a2zhelna/Power-Meter/KiCad Files/PowerMeter_PS_current/project_library/282834-2/STEP/c-282834-2-c-3d.stp

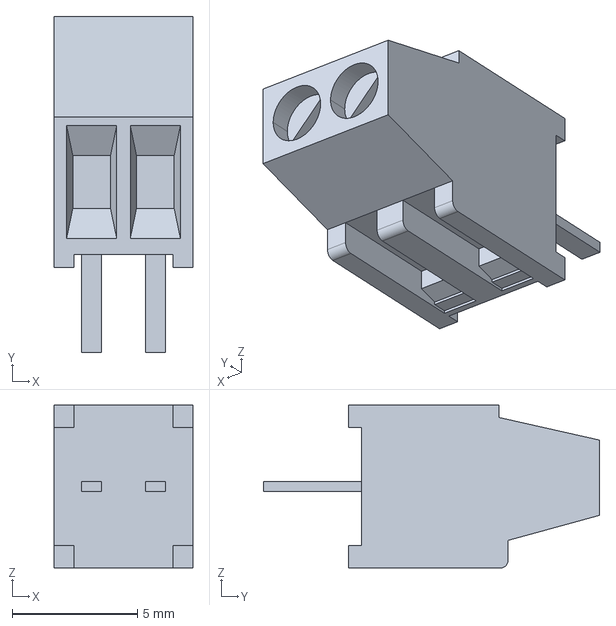
[picture p6: CAD file, 2023-01-08]
KiCad Files/PowerMeter_PS_current/project_library/282834-2/STEP/c-282834-2-c-3d.stp
5.54 x 13.4 x 6.50 mm
