a2zhelna/Power-Meter/KiCad Files/PowerMeter_PS_current/project_library/282834-3/STEP/c-282834-3-c-3d.stp

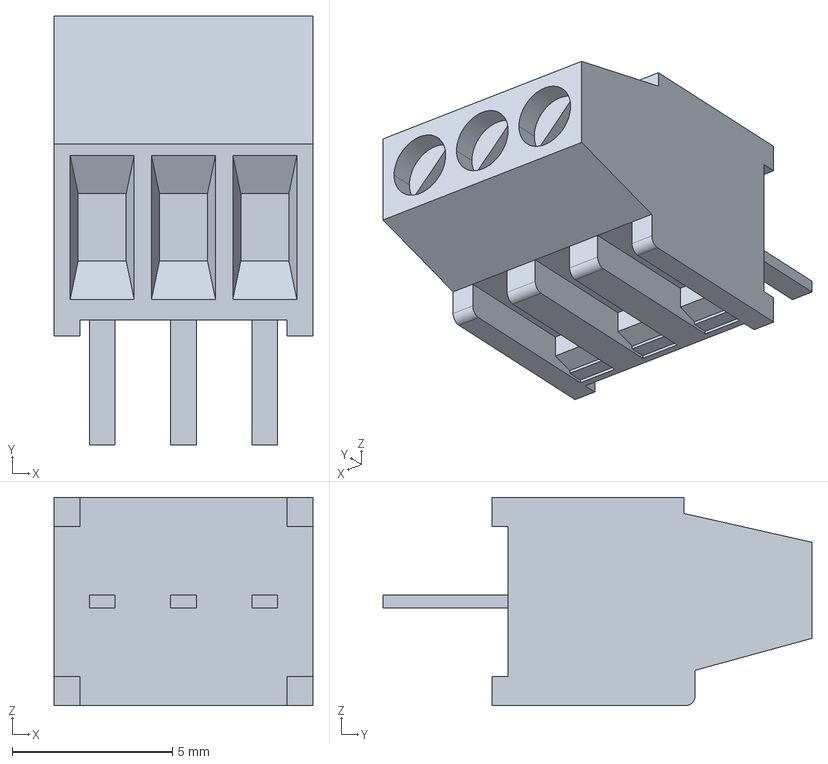
[picture p7: CAD file, 2023-01-08]
KiCad Files/PowerMeter_PS_current/project_library/282834-3/STEP/c-282834-3-c-3d.stp
8.08 x 13.4 x 6.50 mm
