a2zhelna/Power-Meter/KiCad Files/PowerMeter_PS_current/project_library/282834-4/STEP/c-282834-4-c-3d.stp

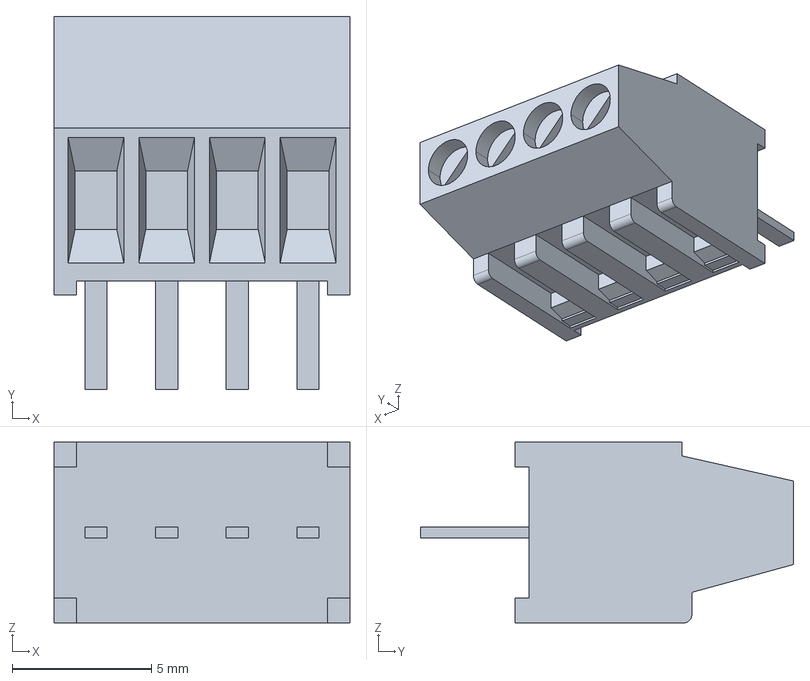
[picture p8: CAD file, 2023-01-08]
KiCad Files/PowerMeter_PS_current/project_library/282834-4/STEP/c-282834-4-c-3d.stp
10.6 x 13.4 x 6.50 mm
