a2zhelna/Power-Meter/KiCad Files/PowerMeter_PS_current/project_library/AP2112K-3-3TRG1/2022-11-07_20-57-51/STEP/SOT_RG1_DIO.step

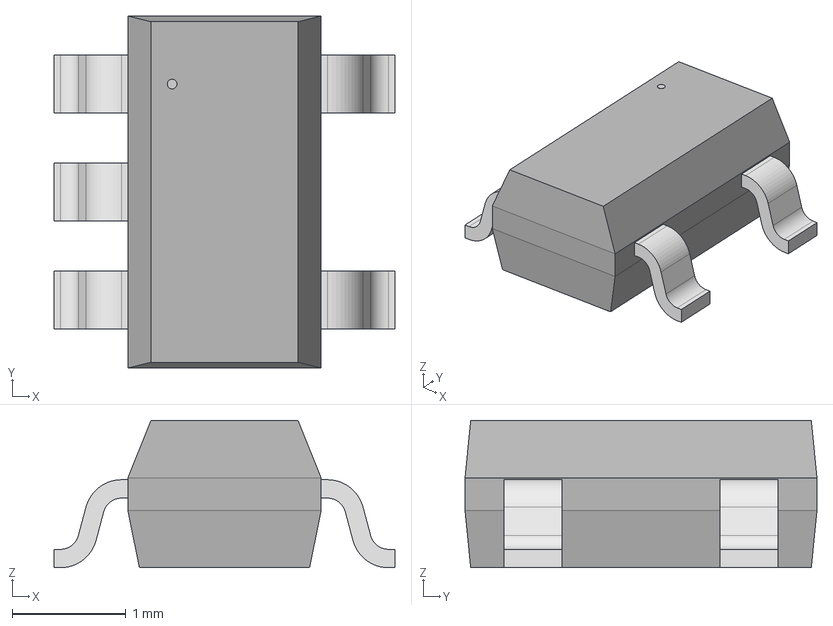
[picture p9: CAD file, 2023-01-08]
KiCad Files/PowerMeter_PS_current/project_library/AP2112K-3-3TRG1/2022-11-07_20-57-51/STEP/SOT_RG1_DIO.step
3.00 x 3.10 x 1.30 mm
