a2zhelna/Power-Meter/KiCad Files/PowerMeter_PS_current/project_library/KMB28STR/3D/KMB28STR.stp

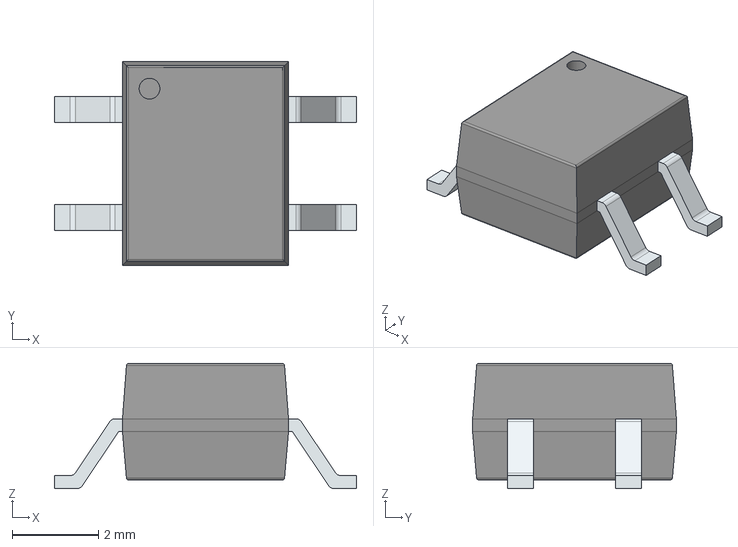
[picture p10: CAD file, 2023-01-08]
KiCad Files/PowerMeter_PS_current/project_library/KMB28STR/3D/KMB28STR.stp
7.00 x 4.72 x 2.90 mm
PinsArrayLR
