a2zhelna/Power-Meter/KiCad Files/PowerMeter_PS_current/project_library/LD1085V50/2022-11-07_20-40-51/STEP/TO-220_STM.step

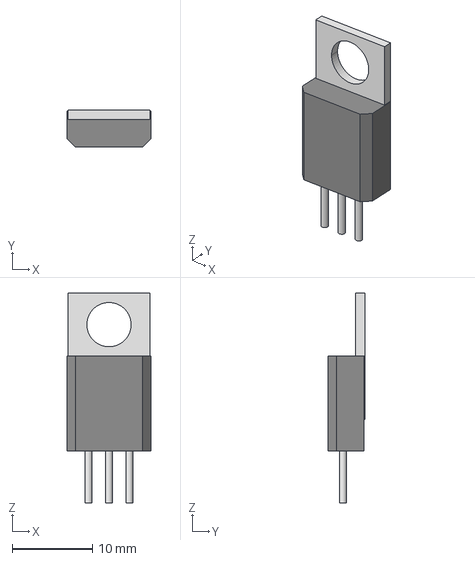
[picture p11: CAD file, 2023-01-08]
KiCad Files/PowerMeter_PS_current/project_library/LD1085V50/2022-11-07_20-40-51/STEP/TO-220_STM.step
10.4 x 4.60 x 26.2 mm
