a2zhelna/Power-Meter/KiCad Files/PowerMeter_PS_current/project_library/LIB_TS360ILS_R1_00001/TS360ILS_R1_00001/3D/TS360ILS_R1_00001.stp

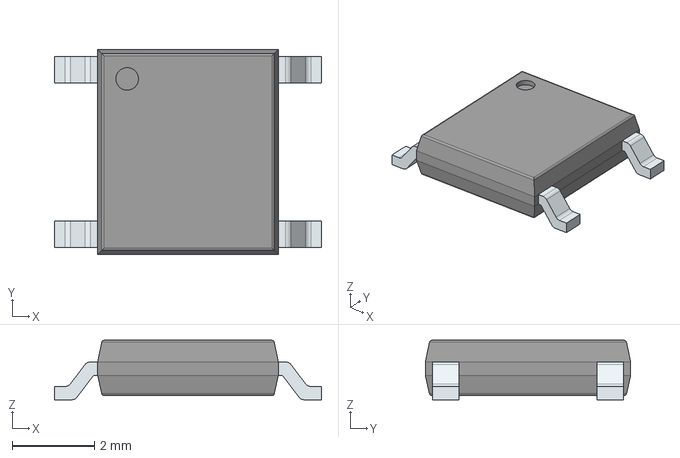
[picture p12: CAD file, 2023-01-08]
KiCad Files/PowerMeter_PS_current/project_library/LIB_TS360ILS_R1_00001/TS360ILS_R1_00001/3D/TS360ILS_R1_00001.stp
6.50 x 5.00 x 1.45 mm
PinsArrayLR
