a2zhelna/Power-Meter/KiCad Files/PowerMeter_PS_current/project_library/LM320T-15-NOPB/STEP/NDE0003B.stp

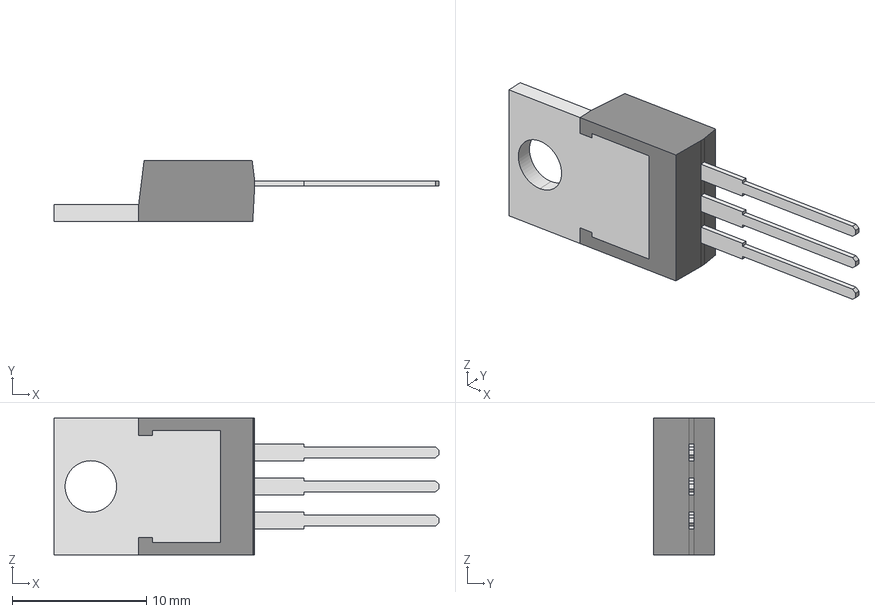
[picture p13: CAD file, 2023-01-08]
KiCad Files/PowerMeter_PS_current/project_library/LM320T-15-NOPB/STEP/NDE0003B.stp
28.7 x 4.57 x 10.2 mm
T03B_BODY
T03B_LEAD x 3
T03B_HS
