a2zhelna/Power-Meter/KiCad Files/PowerMeter_PS_current/project_library/LP2989IMX-5-0-NOPBu/STEP/D0008A.stp

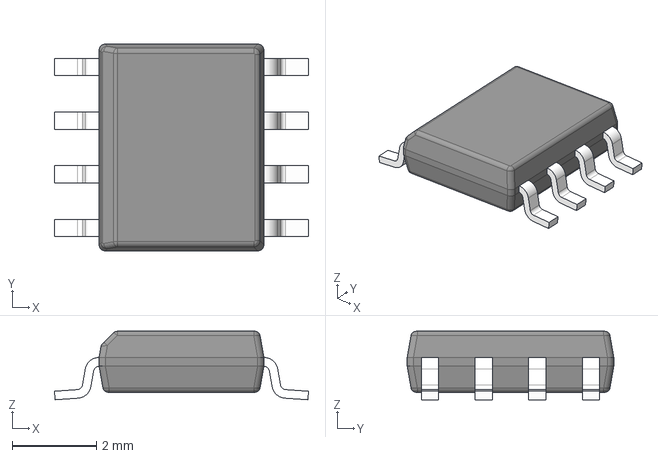
[picture p14: CAD file, 2023-01-08]
KiCad Files/PowerMeter_PS_current/project_library/LP2989IMX-5-0-NOPBu/STEP/D0008A.stp
6.02 x 4.90 x 1.63 mm
BODY-SO
LEAD-D0008A x 8
