a2zhelna/Power-Meter/KiCad Files/PowerMeter_PS_current/project_library/LP2989IMX-5.0_NOPB/LP2989IMX-5.0_NOPB.step

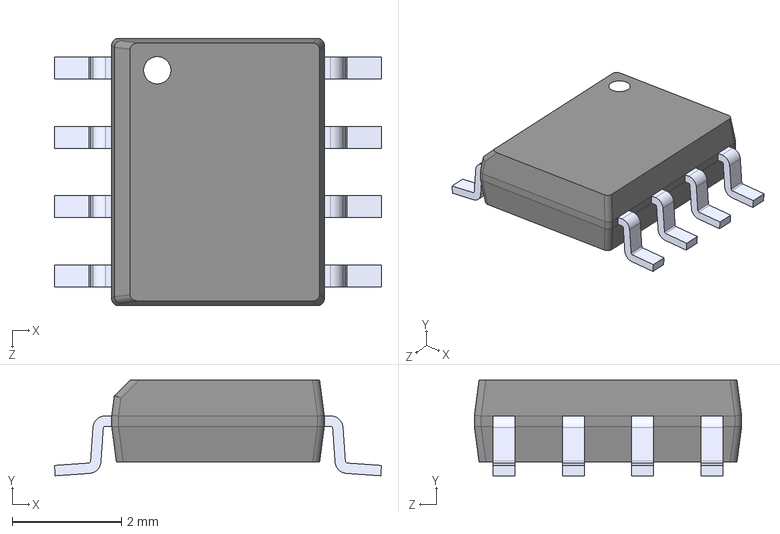
[picture p15: CAD file, 2023-01-08]
KiCad Files/PowerMeter_PS_current/project_library/LP2989IMX-5.0_NOPB/LP2989IMX-5.0_NOPB.step
5.99 x 1.75 x 4.90 mm
