a2zhelna/Power-Meter/KiCad Files/PowerMeter_PS_current/project_library/S16-4148E3-TR7/2022-11-08_01-20-33/STEP/SOIC16_MIS.step

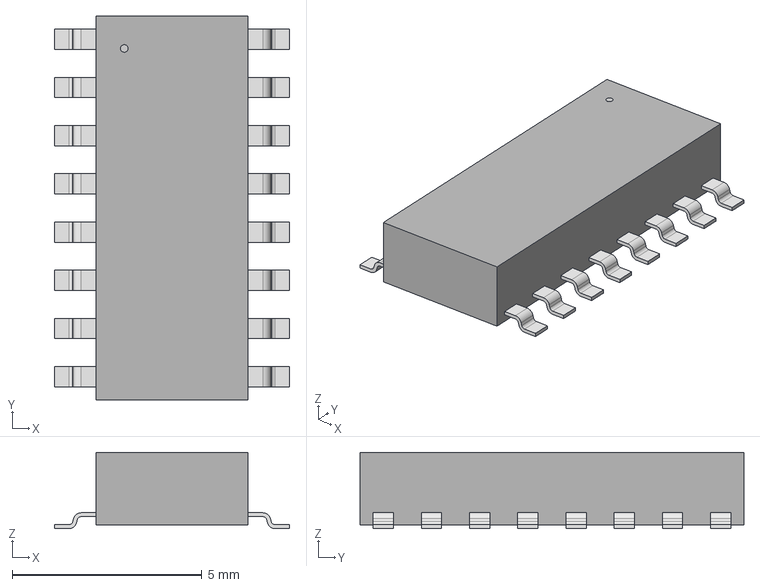
[picture p16: CAD file, 2023-01-08]
KiCad Files/PowerMeter_PS_current/project_library/S16-4148E3-TR7/2022-11-08_01-20-33/STEP/SOIC16_MIS.step
6.20 x 10.1 x 2.01 mm
