a2zhelna/Power-Meter/KiCad Files/PowerMeter_PS_current/project_library/S16-4148E3_TR7u/S16-4148E3_TR7.step

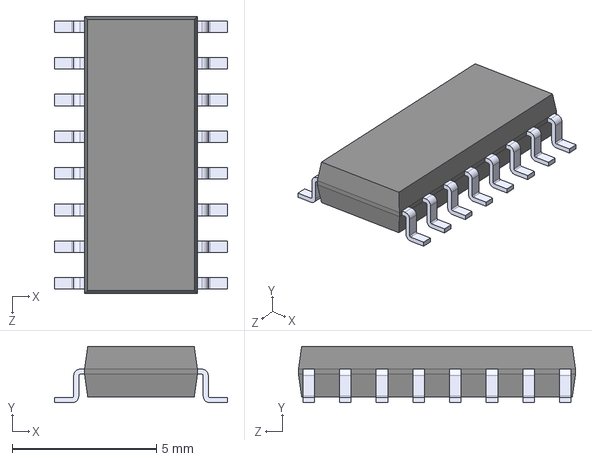
[picture p17: CAD file, 2023-01-08]
KiCad Files/PowerMeter_PS_current/project_library/S16-4148E3_TR7u/S16-4148E3_TR7.step
5.99 x 1.95 x 9.59 mm
