a2zhelna/Power-Meter/(list of files, cad)

Other CAD files:
KiCad Files/PowerMeter_PS_current/project_library/KMB28STR/Allegro/sop250p700x290-4n.psm
KiCad Files/PowerMeter_PS_current/project_library/KMB28STR/DEHDL/kmb28str/chips/chips.prt
KiCad Files/PowerMeter_PS_current/project_library/LIB_TS360ILS_R1_00001/TS360ILS_R1_00001/Allegro/sop400p650x145-4n.psm
KiCad Files/PowerMeter_PS_current/project_library/LIB_TS360ILS_R1_00001/TS360ILS_R1_00001/DEHDL/ts360ils_r1_00001/chips/chips.prt
KiCad Files/PowerMeter_PS_modified/project_library/KMB28STR/Allegro/sop250p700x290-4n.psm
KiCad Files/PowerMeter_PS_modified/project_library/KMB28STR/DEHDL/kmb28str/chips/chips.prt
KiCad Files/PowerMeter_PS_modified/project_library/LIB_TS360ILS_R1_00001/TS360ILS_R1_00001/Allegro/sop400p650x145-4n.psm
KiCad Files/PowerMeter_PS_modified/project_library/LIB_TS360ILS_R1_00001/TS360ILS_R1_00001/DEHDL/ts360ils_r1_00001/chips/chips.prt
