a2zhelna/Power-Meter/Schematics/PowerMeter_PCB.pdf

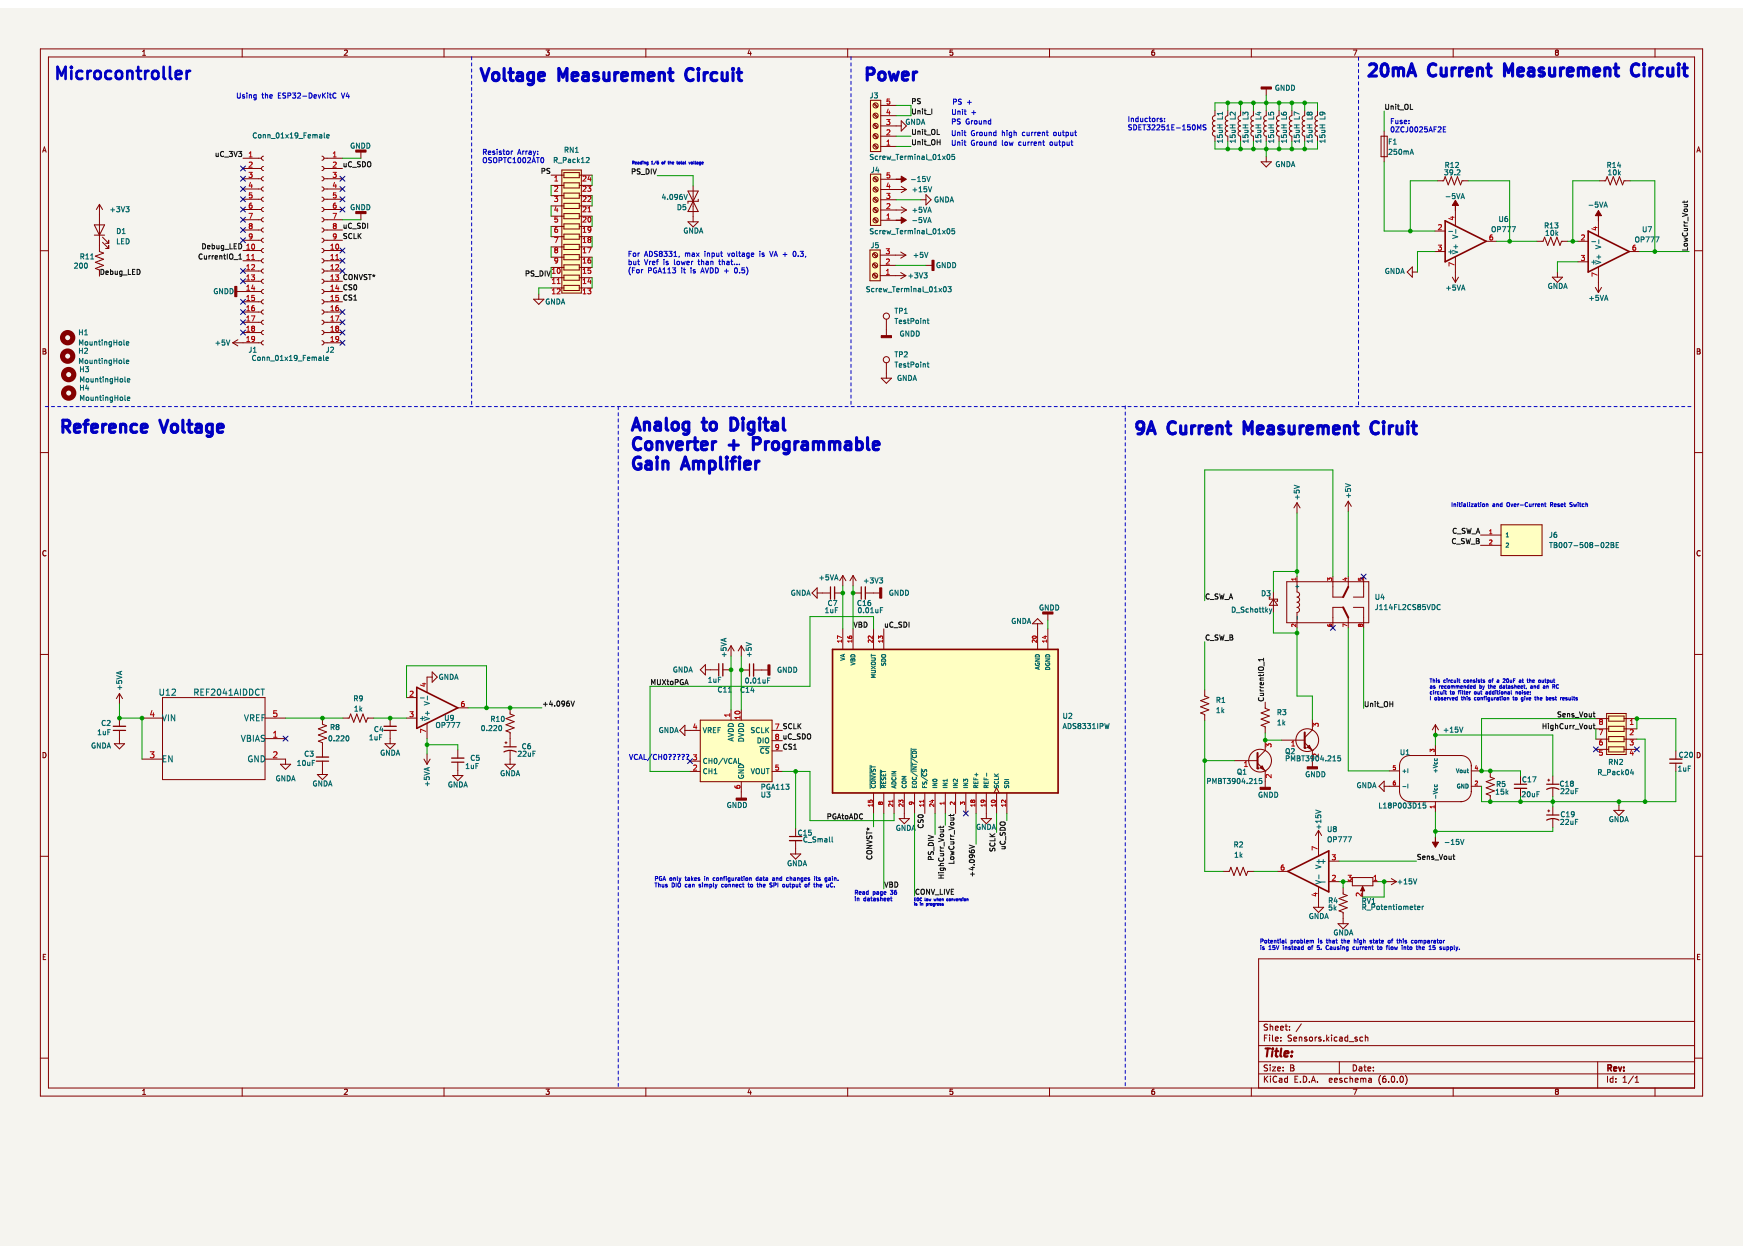
[picture p21: page 1]
