a2zhelna/Power-Meter/Schematics/PowerMeter_PCB_modified.pdf

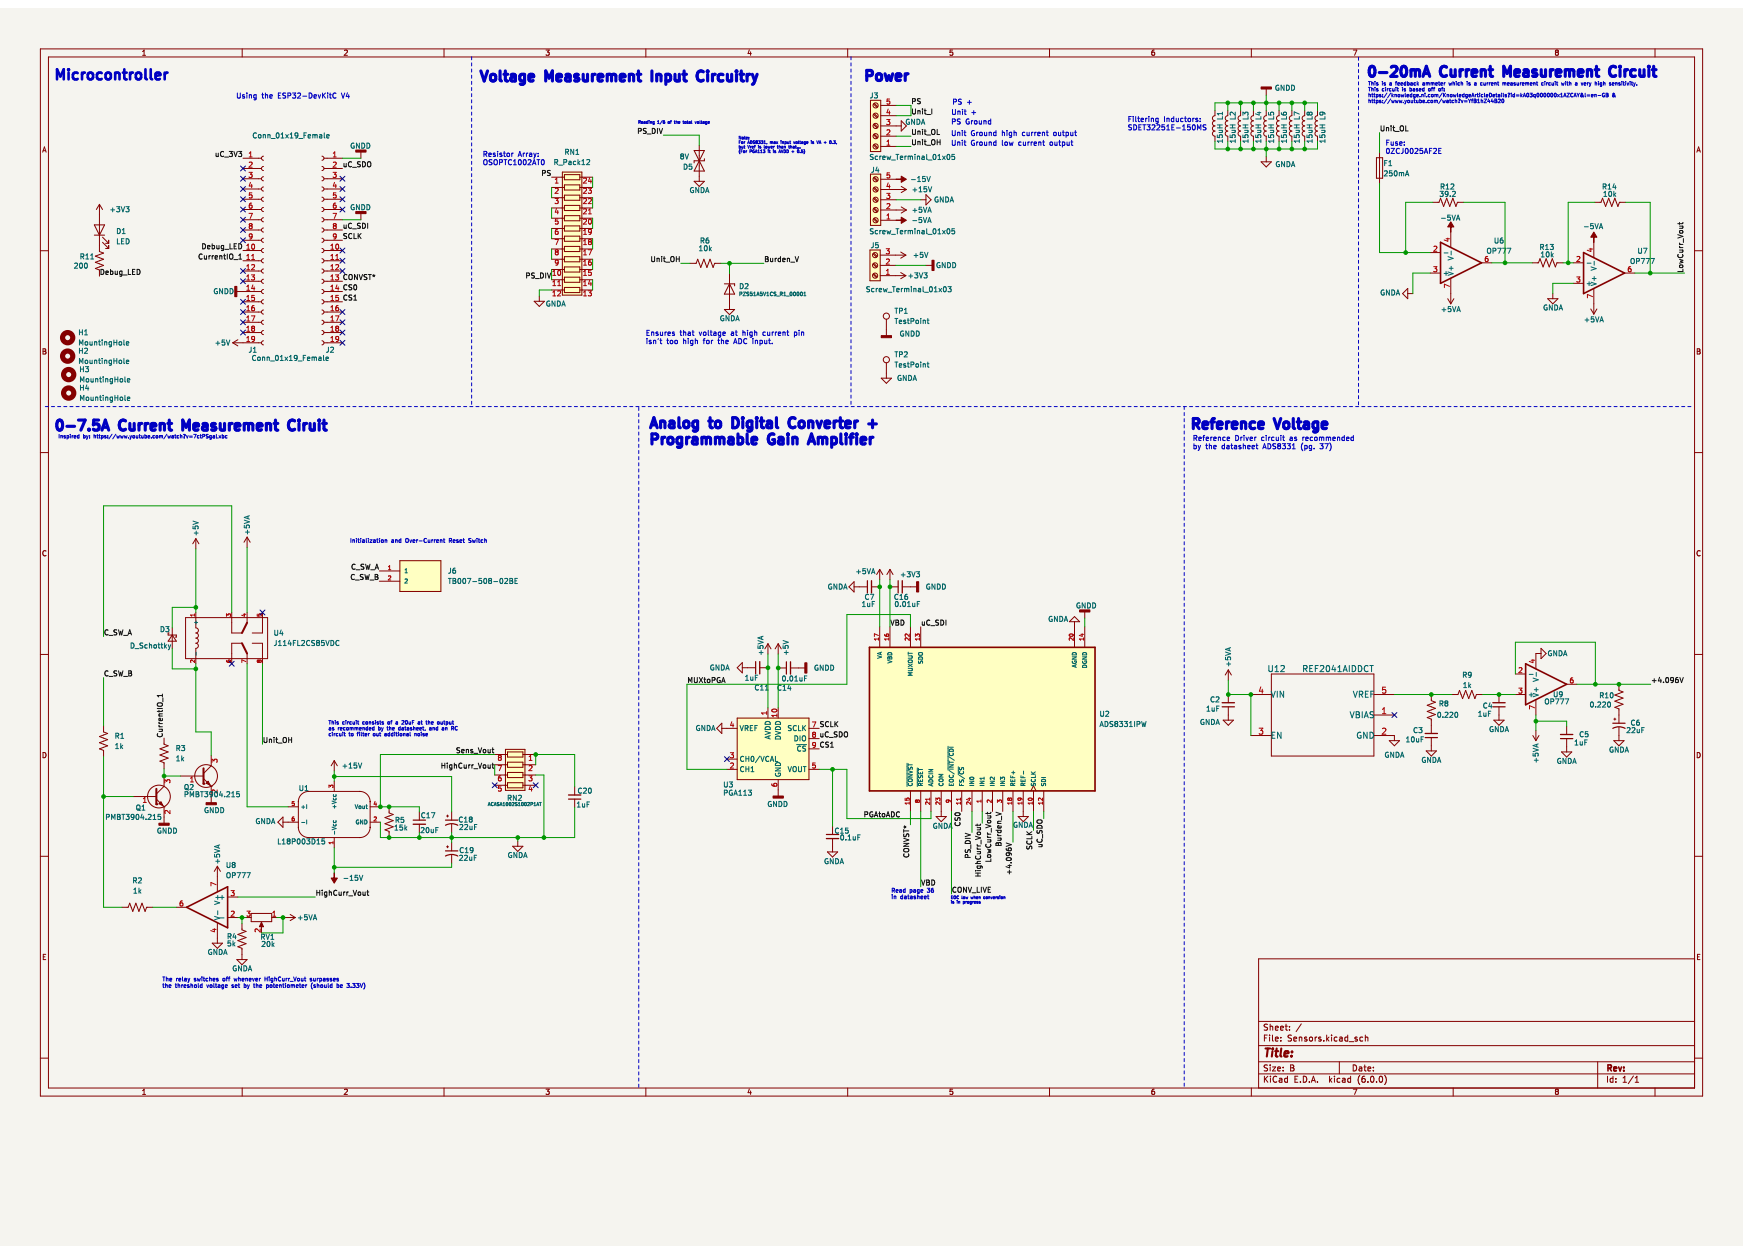
[picture p22: page 1]
