a2zhelna/Power-Meter/Schematics/PowerMeter_PS.pdf

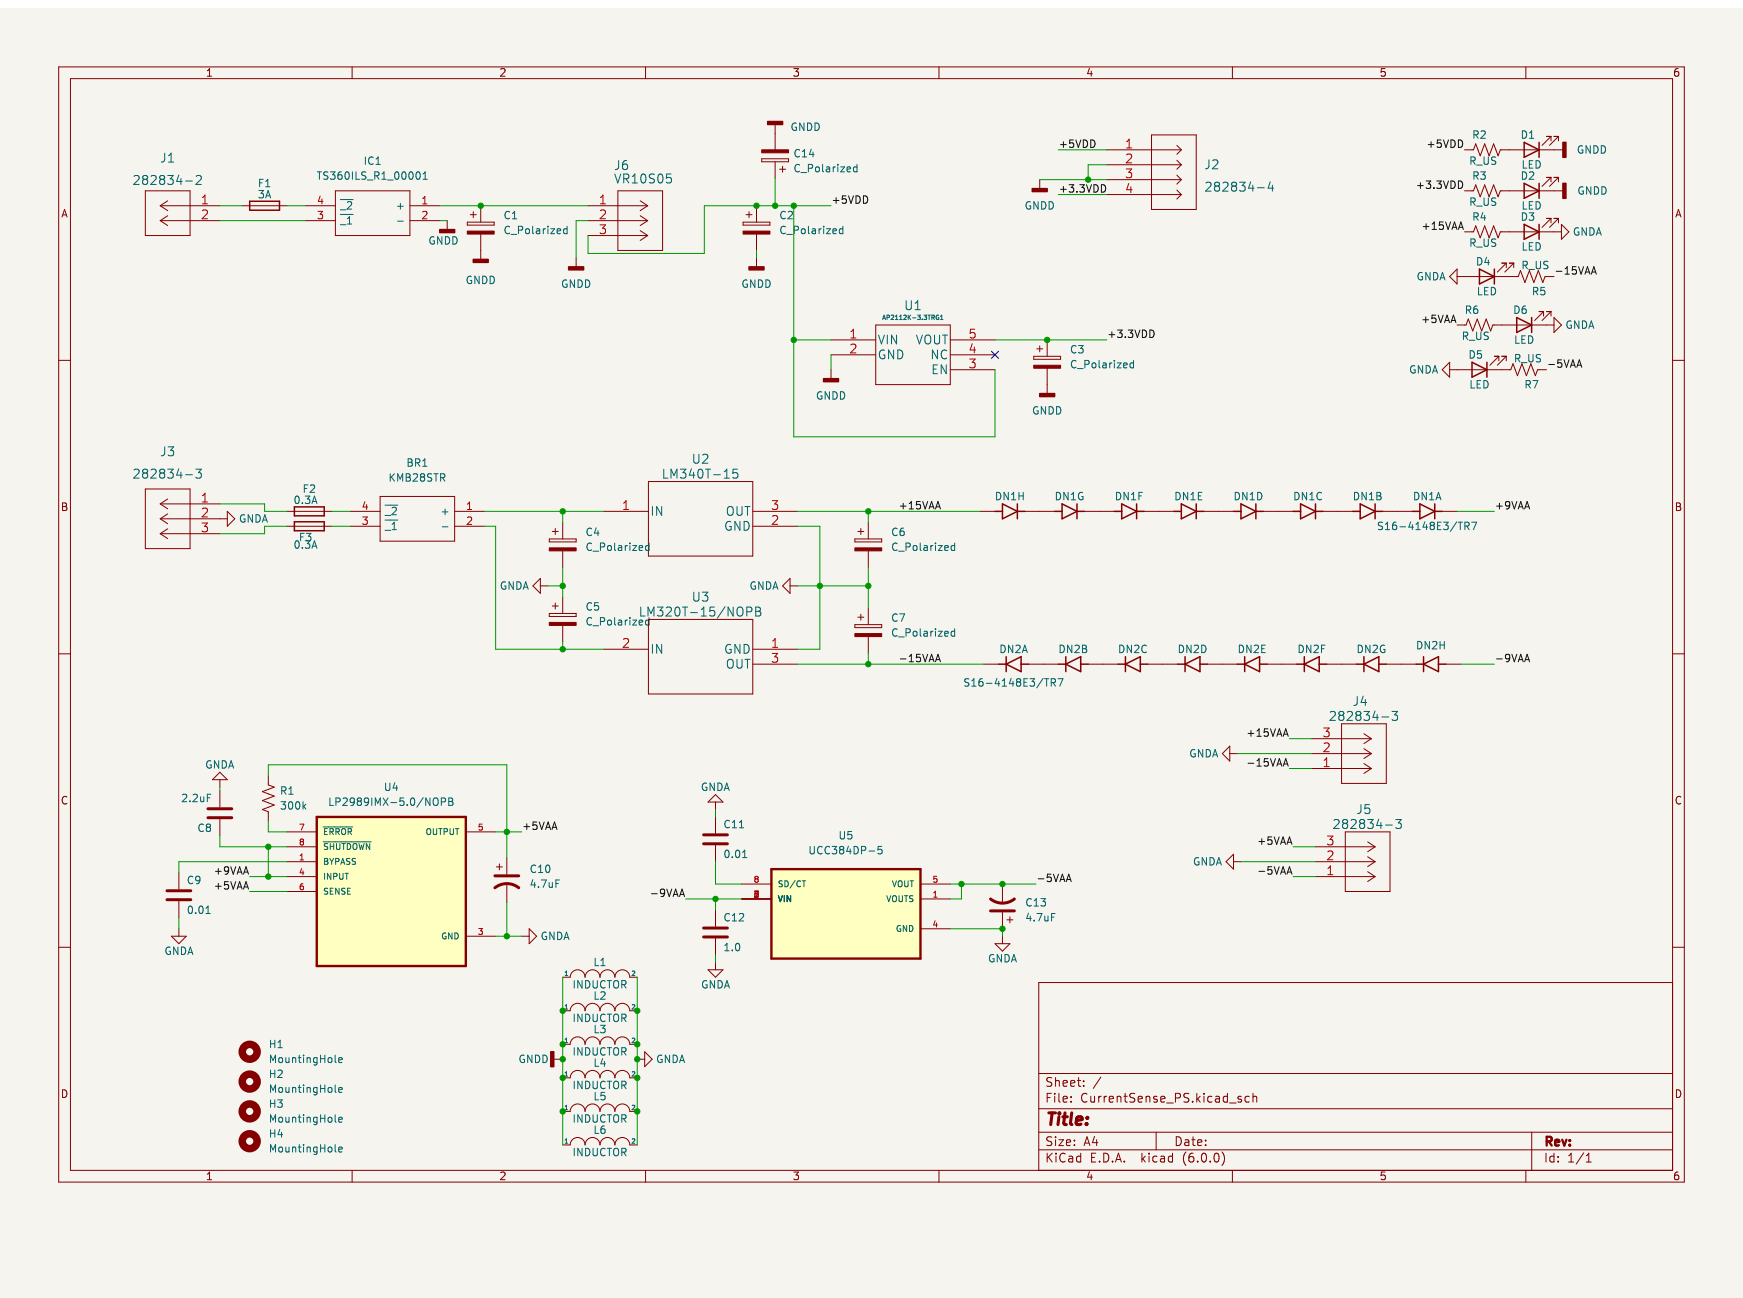
[picture p23: page 1]
