a2zhelna/Power-Meter/Schematics/PowerMeter_PS_modified.pdf

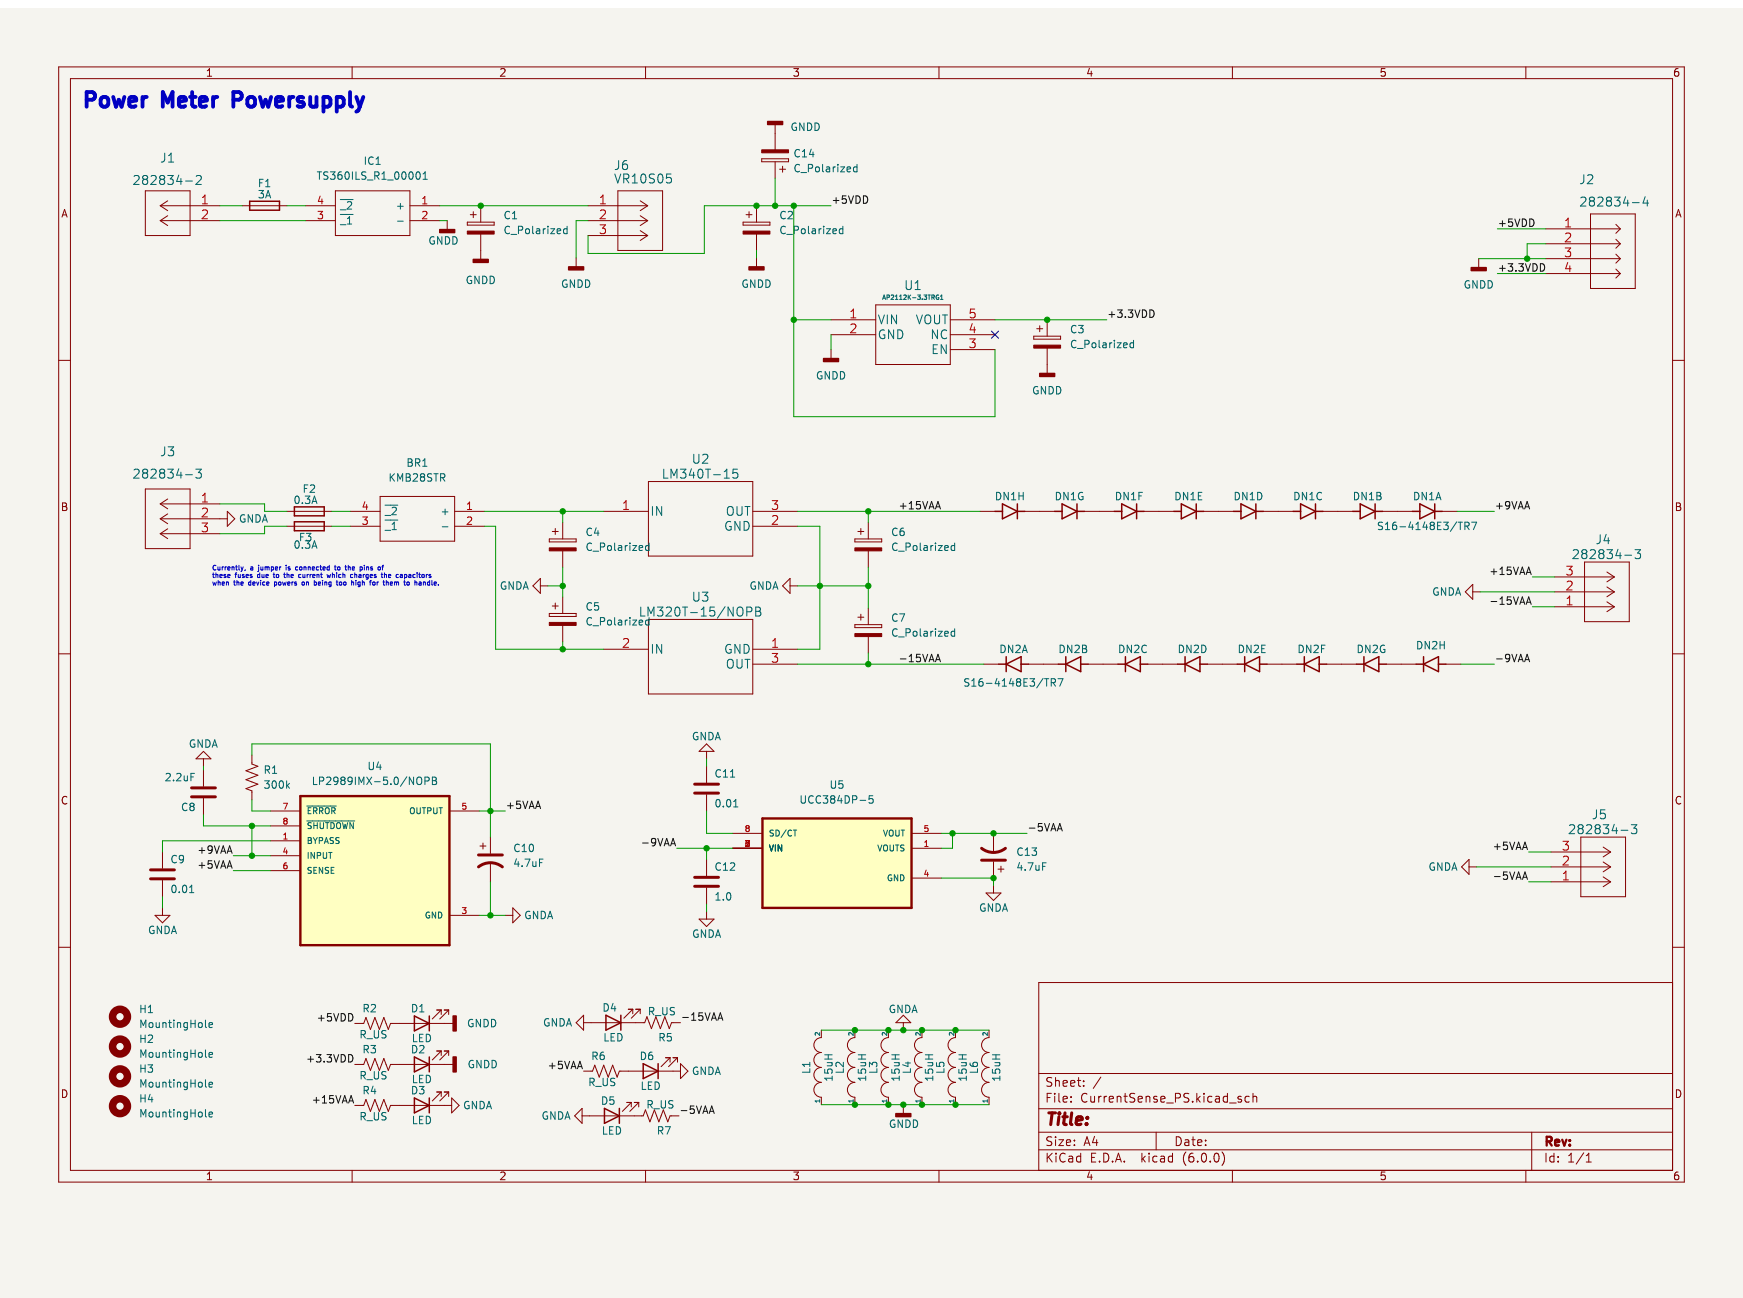
[picture p24: page 1]
