a2zhelna/Power-Meter/(list of files, drawings)

Other design files:
KiCad Files/PowerMeter_PS_current/project_library/KMB28STR/Altium/KMB28STR.SchLib
KiCad Files/PowerMeter_PS_current/project_library/KMB28STR/Altium/SOP250P700X290-4N.PcbLib
KiCad Files/PowerMeter_PS_current/project_library/LIB_TS360ILS_R1_00001/TS360ILS_R1_00001/Altium/SOP400P650X145-4N.PcbLib
KiCad Files/PowerMeter_PS_current/project_library/LIB_TS360ILS_R1_00001/TS360ILS_R1_00001/Altium/TS360ILS_R1_00001.SchLib
KiCad Files/PowerMeter_PS_modified/project_library/KMB28STR/Altium/KMB28STR.SchLib
KiCad Files/PowerMeter_PS_modified/project_library/KMB28STR/Altium/SOP250P700X290-4N.PcbLib
KiCad Files/PowerMeter_PS_modified/project_library/LIB_TS360ILS_R1_00001/TS360ILS_R1_00001/Altium/SOP400P650X145-4N.PcbLib
KiCad Files/PowerMeter_PS_modified/project_library/LIB_TS360ILS_R1_00001/TS360ILS_R1_00001/Altium/TS360ILS_R1_00001.SchLib
