a2zhelna/Power-Meter/KiCad Files/PowerMeter_PS_modified/CurrentSense_PS.kicad_pcb

## KiCad design KiCad Files/PowerMeter_PS_modified/CurrentSense_PS.kicad_pcb (2023-01-08)

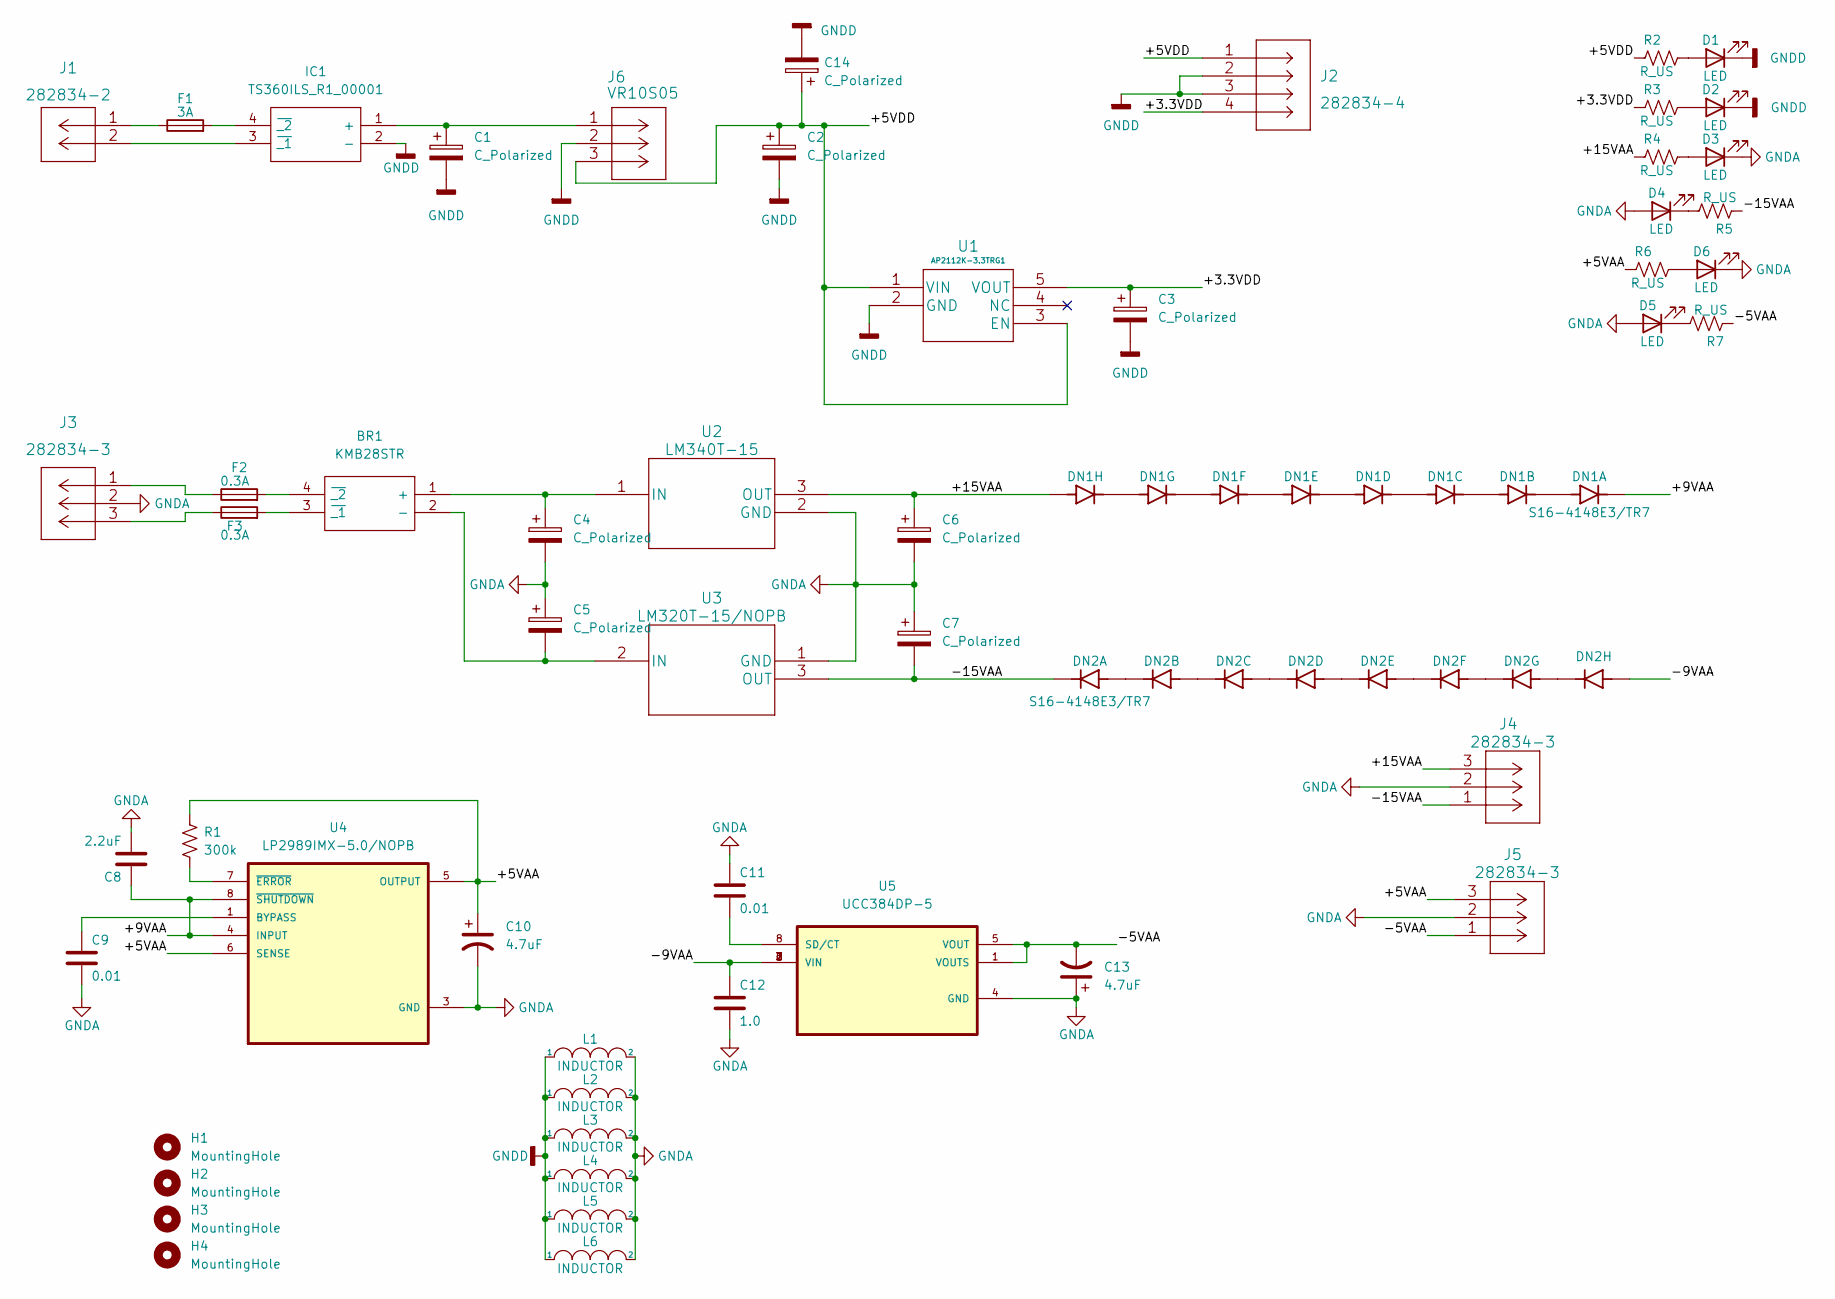
[picture p25: schematic CurrentSense_PS.kicad_sch]

Parts:
BR1: KMB28STR; SOP250P700X290-4N; Manufacturer_Part_Number KMB28STR
C1, C2, C3, C4, C5, C6, C7, C14: C_Polarized; CP_Radial_D5.0mm_P2.50mm
C8: 2.2uF; C_0805_2012Metric
C9, C11: 0.01; C_0603_1608Metric
C10, C13: 4.7uF; CP_EIA-7343-15_Kemet-W
C12: 1.0; C_0603_1608Metric
D1, D2, D3, D4, D5, D6: LED; LED_0603_1608Metric
DN1, DN2: S16-4148E3/TR7; SOIC127P599X195-16N; PARTREV G
F1: 3A; Fuse_1206_3216Metric
F2, F3: 0.3A; Fuse_1206_3216Metric
H1, H2, H3, H4: MountingHole; MountingHole_3.2mm_M3
IC1: TS360ILS_R1_00001; SOP400P650X145-4N; Mouser Part Number 241-TS360ILSR100001
J1: 282834-2
J2: 282834-4
J3, J4, J5: 282834-3
J6: VR10S05
L1, L2, L3, L4, L5, L6: INDUCTOR; L_1206_3216Metric
R1: 300k; R_0603_1608Metric
R2, R3, R4, R5, R6, R7: R_US; R_0603_1608Metric
U1: AP2112K-3.3TRG1
U2: LM340T-15
U3: LM320T-15/NOPB; LM320T-15&slash_NOPB
U4: LP2989IMX-5.0/NOPB; SOIC127P599X175-8N
U5: UCC384DP-5; SOIC127P599X175-8N

Connections:
/+3.3VDD: C3.1, J2.4, R3.1, U1.5 (VOUT)
/+5VAA: C10.1, J5.3, R1.1, R6.1, U4.5 (OUTPUT), U4.6 (SENSE)
/+5VDD: C2.1, C14.1, J2.1, J6.3, R2.1, U1.1 (VIN), U1.3 (EN)
/+9VAA: C8.1, DN1.1, U4.4 (INPUT), U4.8 (~SHUTDOWN)
/+15VAA: C6.1, DN1.9, J4.3, R4.1, U2.3 (OUT)
/-5VAA: C13.2, J5.1, R7.1, U5.1 (VOUTS), U5.5 (VOUT)
/-9VAA: C12.1, DN2.9, U5.2 (VIN), U5.3 (VIN), U5.6 (VIN), U5.7 (VIN)
/-15VAA: C7.2, DN2.1, J4.1, R5.1, U3.3 (OUT)
GNDA: C4.2, C5.1, C6.2, C7.1, C8.2, C9.2, C10.2, C11.1, C12.2, C13.1, D3.1 (K), D4.2 (A), D5.2 (A), D6.1 (K), J3.2, J4.2, J5.2, L1.2, L2.2, L3.2, L4.2, L5.2, L6.2, U2.2 (GND), U3.1 (GND), U4.3 (GND), U5.4 (GND)
GNDD: C1.2, C2.2, C3.2, C14.2, D1.1 (K), D2.1 (K), IC1.2 (-), J2.2, J2.3, J6.2, L1.1, L2.1, L3.1, L4.1, L5.1, L6.1, U1.2 (GND)
unnamed: BR1.1 (+), C4.1, U2.1 (IN)
unnamed: BR1.2 (-), C5.2, U3.2 (IN)
unnamed: BR1.3 (~_1), F3.2
unnamed: BR1.4 (~_2), F2.2
unnamed: C1.1, IC1.1 (+), J6.1
unnamed: C9.1, U4.1 (BYPASS)
unnamed: C11.2, U5.8 (SD/CT)
unnamed: D1.2 (A), R2.2
unnamed: D2.2 (A), R3.2
unnamed: D3.2 (A), R4.2
unnamed: D4.1 (K), R5.2
unnamed: D5.1 (K), R7.2
unnamed: D6.2 (A), R6.2
unnamed: DN1.8, DN1.10
unnamed: DN1.7, DN1.11
unnamed: DN1.6, DN1.12
unnamed: DN1.5, DN1.13
unnamed: DN1.4, DN1.14
unnamed: DN1.3, DN1.15
unnamed: DN1.2, DN1.16
unnamed: DN2.8, DN2.10
unnamed: DN2.7, DN2.11
unnamed: DN2.6, DN2.12
unnamed: DN2.5, DN2.13
unnamed: DN2.4, DN2.14
unnamed: DN2.3, DN2.15
unnamed: DN2.2, DN2.16
unnamed: F1.1, J1.1
unnamed: F1.2, IC1.4 (~_2)
unnamed: F2.1, J3.1
unnamed: F3.1, J3.3
unnamed: IC1.3 (~_1), J1.2
unnamed: R1.2, U4.7 (~ERROR)

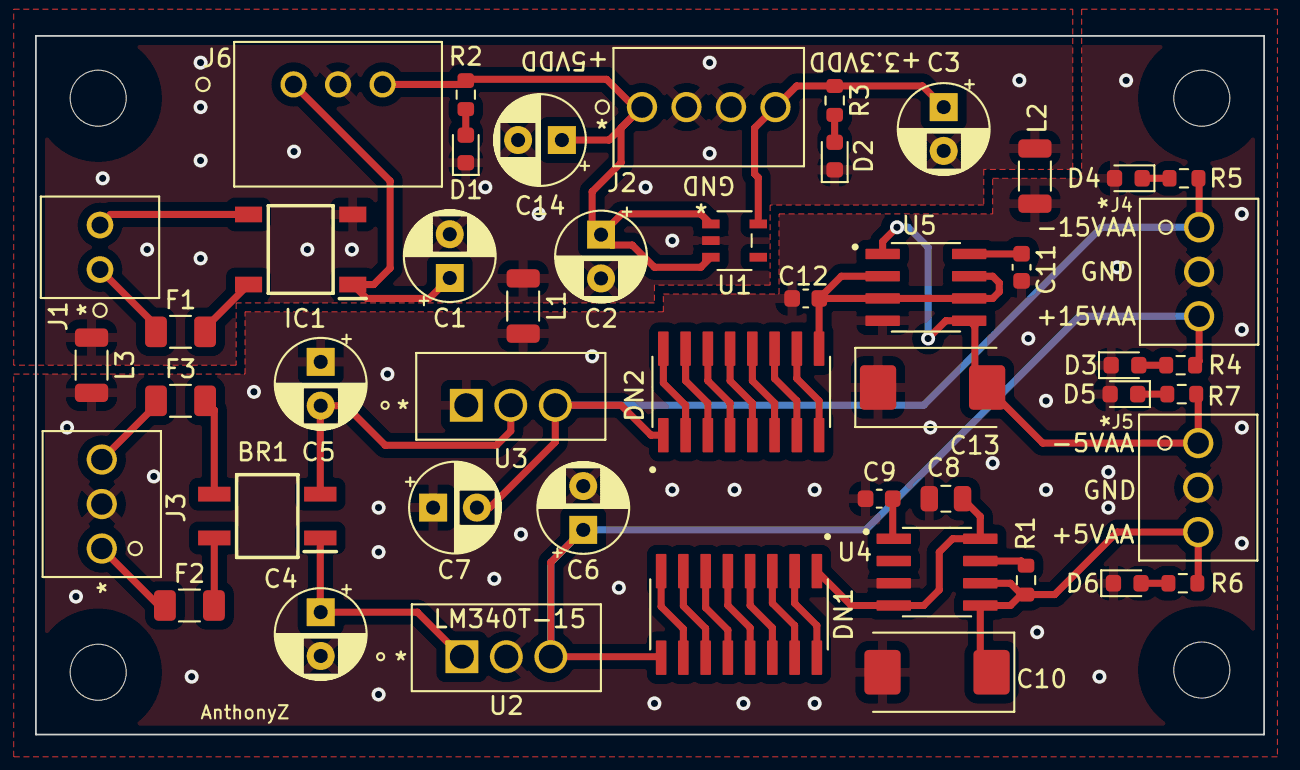
[picture p26: board CurrentSense_PS.kicad_pcb from above]

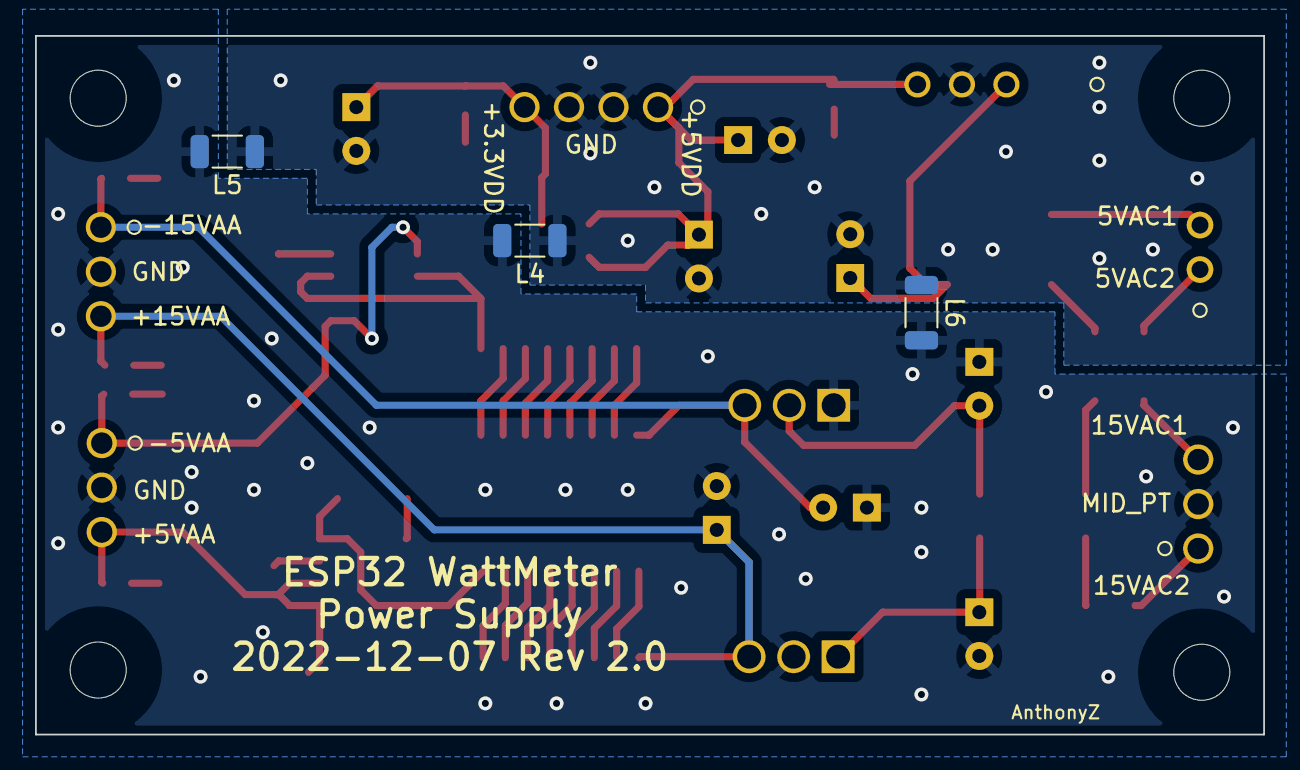
[picture p27: board CurrentSense_PS.kicad_pcb from below]

Board: 2 copper layers, 70.1 x 39.9 mm, 55 parts (3 on the bottom side), 43 nets.
