a2zhelna/Power-Meter/KiCad Files/PowerMeter_PCB_current/Sensors.kicad_pcb

## KiCad design KiCad Files/PowerMeter_PCB_current/Sensors.kicad_pcb (2023-01-08)

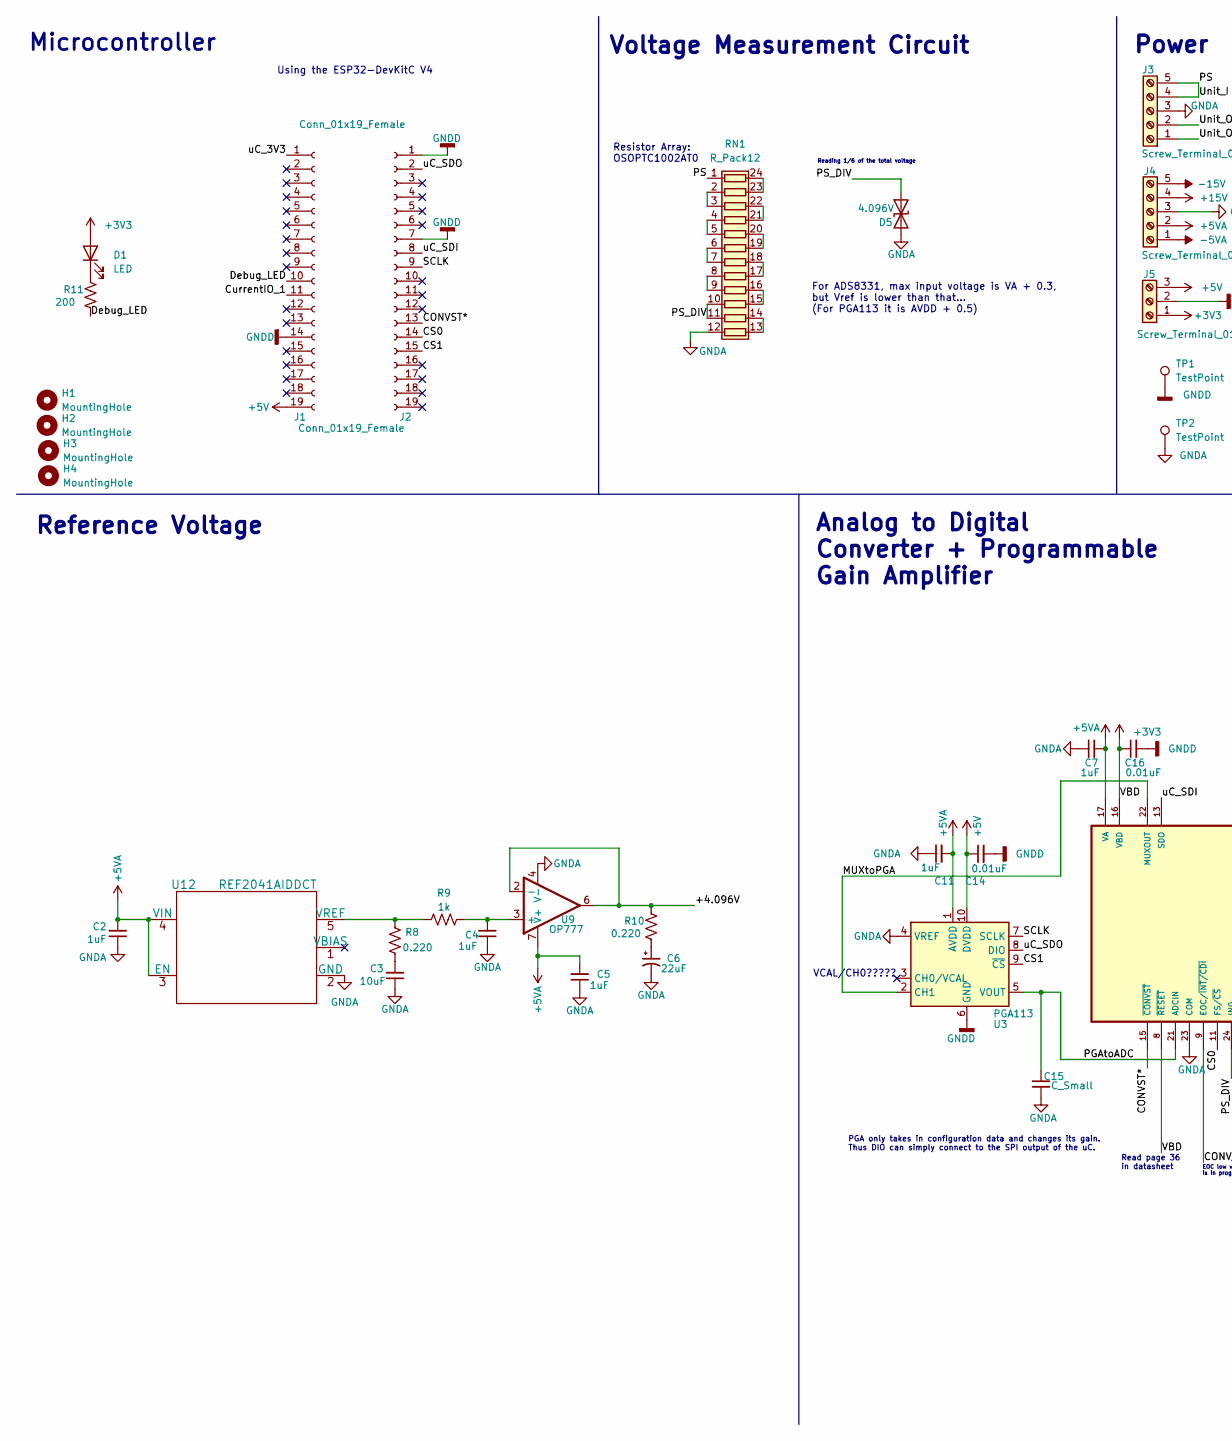
[picture p28: schematic Sensors.kicad_sch, part in row 1, column 1]

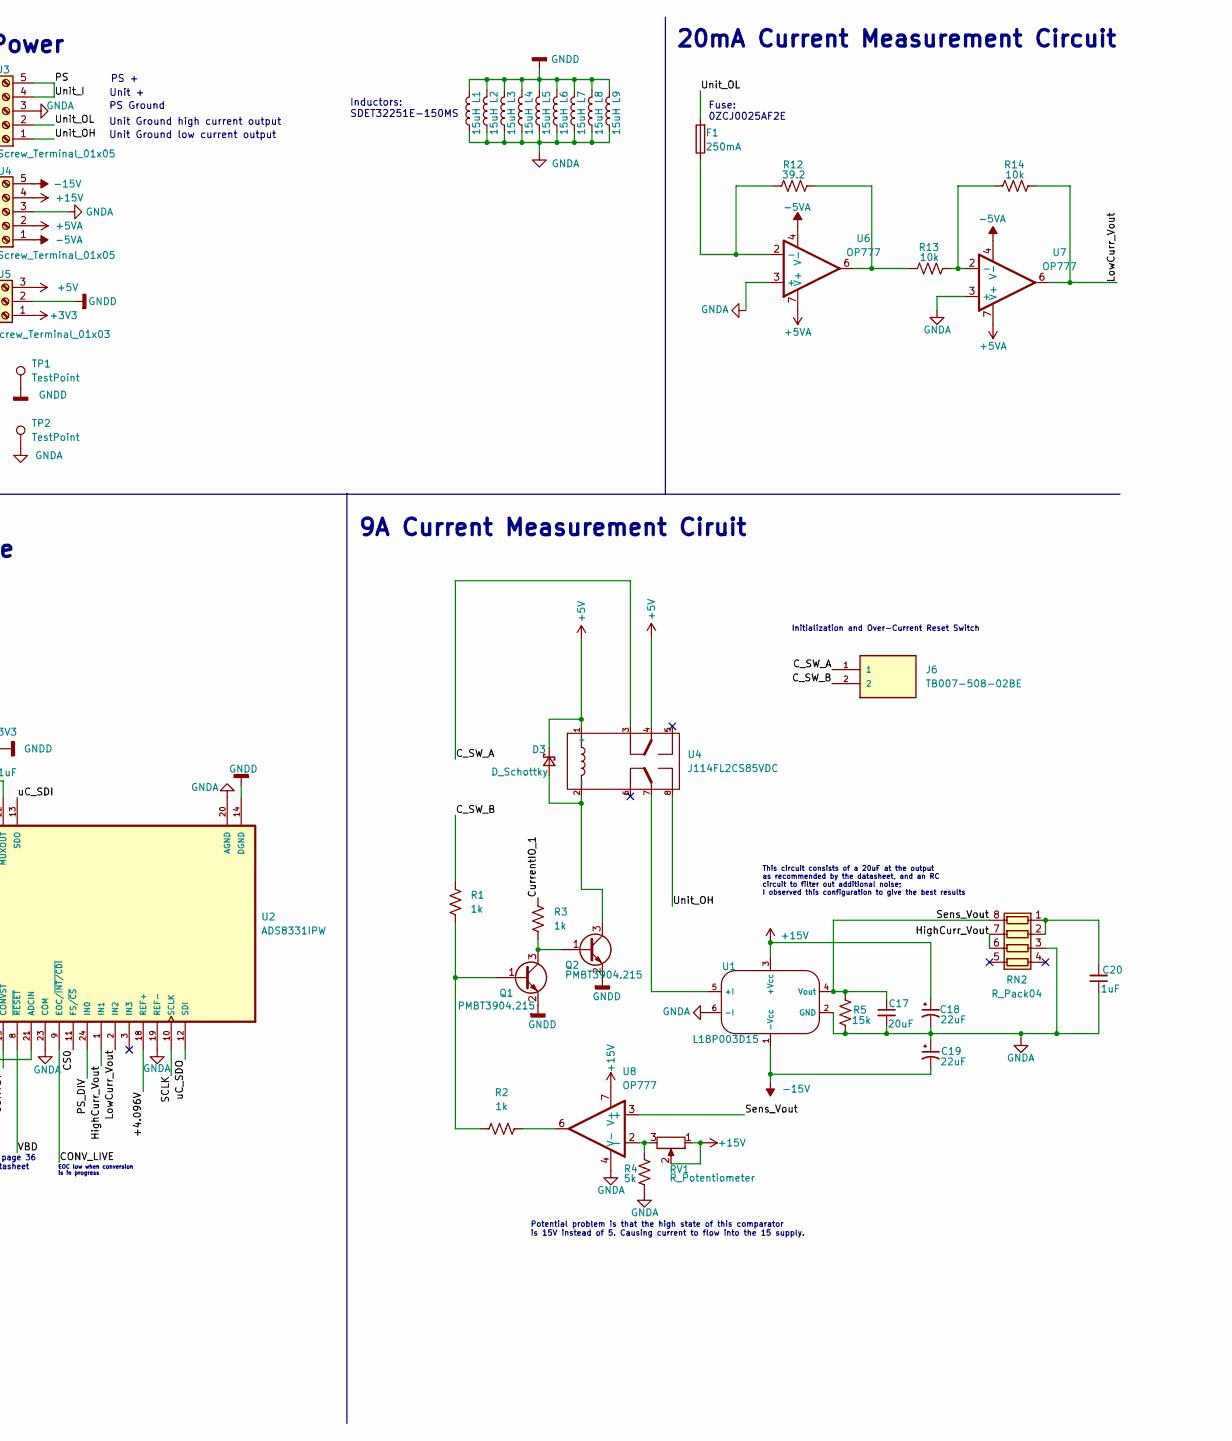
[picture p29: schematic Sensors.kicad_sch, part in row 1, column 2]

Parts:
C2, C4, C5, C7, C11, C20: 1uF; C_0603_1608Metric
C3: 10uF; C_0603_1608Metric
C6, C18, C19: 22uF; 293D226X9020D8T
C14, C16: 0.01uF; C_0603_1608Metric
C15: C_Small; C_0603_1608Metric
C17: 20uF; C_0603_1608Metric
D1: LED; LED_0603_1608Metric
D3: D_Schottky; SOT91P240X102-3N
D5: 4.096V; D_1206_3216Metric
F1: 250mA; Fuse_1206_3216Metric
H1, H2, H3, H4: MountingHole; MountingHole_3.2mm_M3
J1, J2: Conn_01x19_Female; PinSocket_1x19_P2.54mm_Vertical
J3, J4: Screw_Terminal_01x05; CUI_TB007-508-05BE
J5: Screw_Terminal_01x03; TB007-508-03BE
J6: TB007-508-02BE; CUI_TB007-508-02BE
L1, L2, L3, L4, L5, L6, L7, L8, L9: 15uH; SDET32251E-150MS
Q1, Q2: PMBT3904.215; TSOT-23
R1, R2, R3, R9: 1k; R_0603_1608Metric
R4: 5k; R_0603_1608Metric
R5: 15k; R_0603_1608Metric
R8, R10: 0.220; R_0603_1608Metric
R11: 200; R_0603_1608Metric
R12: 39.2; R_0603_1608Metric
R13, R14: 10k; R_0603_1608Metric
RN1: R_Pack12; SSOP-24_3.9x8.7mm_P0.635mm
RN2: R_Pack04; ACASA1002S1002P1AT
RV1: R_Potentiometer; Potentiometer_Bourns_3296W_Vertical
TP1, TP2: TestPoint; TestPoint_THTPad_1.5x1.5mm_Drill0.7mm
U1: L18P003D15
U2: ADS8331IPW; SOP65P640X120-24N
U3: PGA113; TSSOP-10_3x3mm_P0.5mm
U4: J114FL2CS85VDC
U6, U7, U8, U9: OP777; TSSOP-8_3x3mm_P0.65mm
U12: REF2041AIDDCT

Connections:
+3V3: C16.1, D1.2 (A), J5.1, U2.8 (~RESET), U2.16 (VBD)
+5V: C14.1, D3.1 (K), J1.19, J5.3, U3.10 (DVDD), U4.1 (+), U4.4
+5VA: C2.2, C5.2, C7.2, C11.2, J4.2, U2.17 (VA), U3.1 (AVDD), U6.7 (V+), U7.7 (V+), U9.7 (V+), U12.3 (EN), U12.4 (VIN)
+15V: C18.1, J4.4, RV1.1, RV1.2, U1.3 (+Vcc), U8.7 (V+)
-5VA: J4.1, U6.4 (V-), U7.4 (V-)
-15V: C19.2, J4.5, U1.1 (-Vcc)
/+4.096V: R10.1, U2.18 (REF+), U9.2 (-), U9.6
/CONVST*: J2.13, U2.15 (~CONVST)
/CONV_LIVE: U2.9 (EOC/~INT/CDI)
/CS0: J2.14, U2.11 (FS/~CS)
/CS1: J2.15, U3.9 (~CS)
/C_SW_A: J6.1, U4.3
/C_SW_B: J6.2, R1.2
/CurrentIO_1: J1.11, R3.1
/Debug_LED: J1.10, R11.2
/HighCurr_Vout: RN2.6 (R3.2), RN2.7 (R2.2), U2.1 (IN1)
/LowCurr_Vout: R14.1, U2.2 (IN2), U7.6
/MUXtoPGA: U2.22 (MUXOUT), U3.2 (CH1)
/PGAtoADC: C15.1, U2.21 (ADCIN), U3.5 (VOUT)
/PS: J3.4, J3.5, RN1.1 (R1.1)
/PS_DIV: D5.1 (A1), RN1.10 (R10.1), RN1.11 (R11.1), U2.24 (IN0)
/SCLK: J2.9, U2.10 (SCLK), U3.7 (SCLK)
/Sens_Vout: C17.1, R5.2, RN2.8 (R1.2), U1.4 (Vout), U8.3 (+)
/Unit_OH: J3.1, U4.8
/Unit_OL: F1.2, J3.2
/uC_3V3: J1.1
/uC_SDI: J2.8, U2.13 (SDO)
/uC_SDO: J2.2, U2.12 (SDI), U3.8 (DIO)
GNDA: C2.1, C3.1, C4.1, C5.1, C6.2, C7.1, C11.1, C15.2, C17.2, C18.2, C19.1, C20.1, D5.2 (A2), J3.3, J4.3, L1.1, L2.1, L3.1, L4.1, L5.1, L6.1, L7.1, L8.1, L9.1, R4.1, R5.1, RN1.12 (R12.1), RN2.3 (R3.1), TP2.1, U1.2 (GND), U1.6 (-I), U2.19 (REF-), U2.20 (AGND), U2.23 (COM), U3.4 (VREF), U6.3 (+), U7.3 (+), U8.4 (V-), U9.4 (V-), U12.2 (GND)
GNDD: C14.2, C16.2, J1.14, J2.1, J2.7, J5.2, L1.2, L2.2, L3.2, L4.2, L5.2, L6.2, L7.2, L8.2, L9.2, Q1.2 (E), Q2.2 (E), TP1.1, U2.14 (DGND), U3.6 (GND)
unnamed: C3.2, R8.1
unnamed: C4.2, R9.1, U9.3 (+)
unnamed: C6.1, R10.2
unnamed: C20.2, RN2.1 (R1.1), RN2.2 (R2.1)
unnamed: D1.1 (K), R11.1
unnamed: D3.2 (A), Q2.3 (C), U4.2 (-)
unnamed: F1.1, R12.2, U6.2 (-)
unnamed: Q1.1 (B), R1.1, R2.1
unnamed: Q1.3 (C), Q2.1 (B), R3.2
unnamed: R2.2, U8.6
unnamed: R4.2, RV1.3, U8.2 (-)
unnamed: R8.2, R9.2, U12.5 (VREF)
unnamed: R12.1, R13.2, U6.6
unnamed: R13.1, R14.2, U7.2 (-)
unnamed: RN1.2 (R2.1), RN1.3 (R3.1)
unnamed: RN1.4 (R4.1), RN1.5 (R5.1)
unnamed: RN1.6 (R6.1), RN1.7 (R7.1)
unnamed: RN1.8 (R8.1), RN1.9 (R9.1)
unnamed: RN1.13 (R12.2), RN1.14 (R11.2)
unnamed: RN1.15 (R10.2), RN1.16 (R9.2)
unnamed: RN1.17 (R8.2), RN1.18 (R7.2)
unnamed: RN1.19 (R6.2), RN1.20 (R5.2)
unnamed: RN1.21 (R4.2), RN1.22 (R3.2)
unnamed: RN1.23 (R2.2), RN1.24 (R1.2)
unnamed: U1.5 (+I), U4.7

Notes on the sheet:
Potential problem is that the high state of this comparator is 15V instead of 5. Causing current to flow into the 15 supply.
20mA Current Measurement Circuit
Unit +
For ADS8331, max input voltage is VA + 0.3, but Vref is lower than that... (For PGA113 it is AVDD + 0.5)
PS +
Power
Unit Ground low current output
Reference Voltage
Resistor Array: OSOPTC1002AT0
Using the ESP32-DevKitC V4
Microcontroller
This circuit consists of a 20uF at the output as recommended by the datasheet, and an RC circuit to filter out additional noise; I observed this configuration to give the best results
EOC low when conversion is in progress
PS Ground
Initialization and Over-Current Reset Switch
PGA only takes in configuration data and changes its gain. Thus DIO can simply connect to the SPI output of the uC.
Fuse: 0ZCJ0025AF2E
Read page 36 in datasheet
VCAL/CH0?????
Voltage Measurement Circuit
Inductors: SDET32251E-150MS
Analog to Digital Converter + Programmable Gain Amplifier
9A Current Measurement Ciruit
Reading 1/6 of the total voltage
Unit Ground high current output

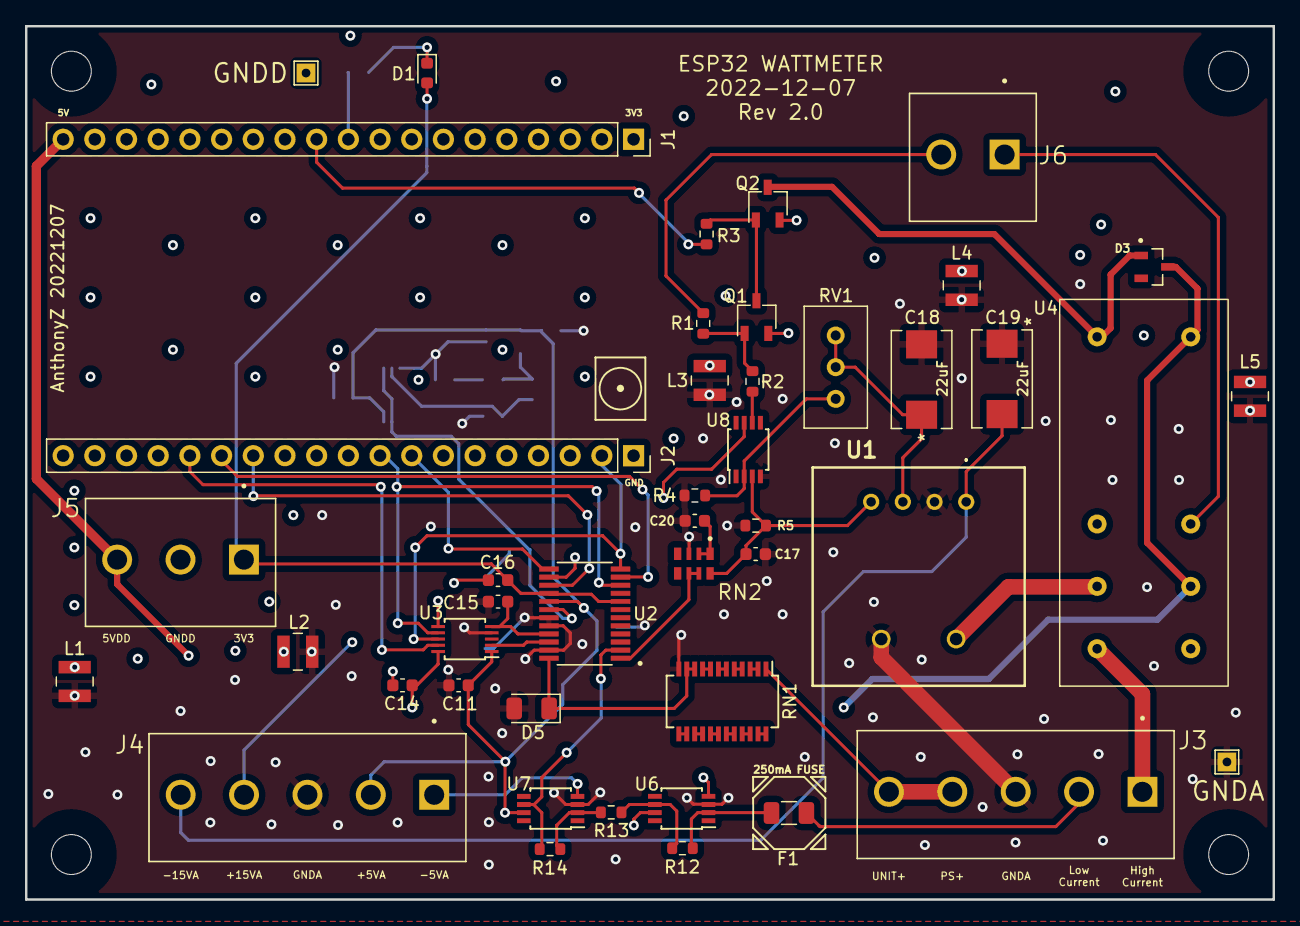
[picture p30: board Sensors.kicad_pcb from above]

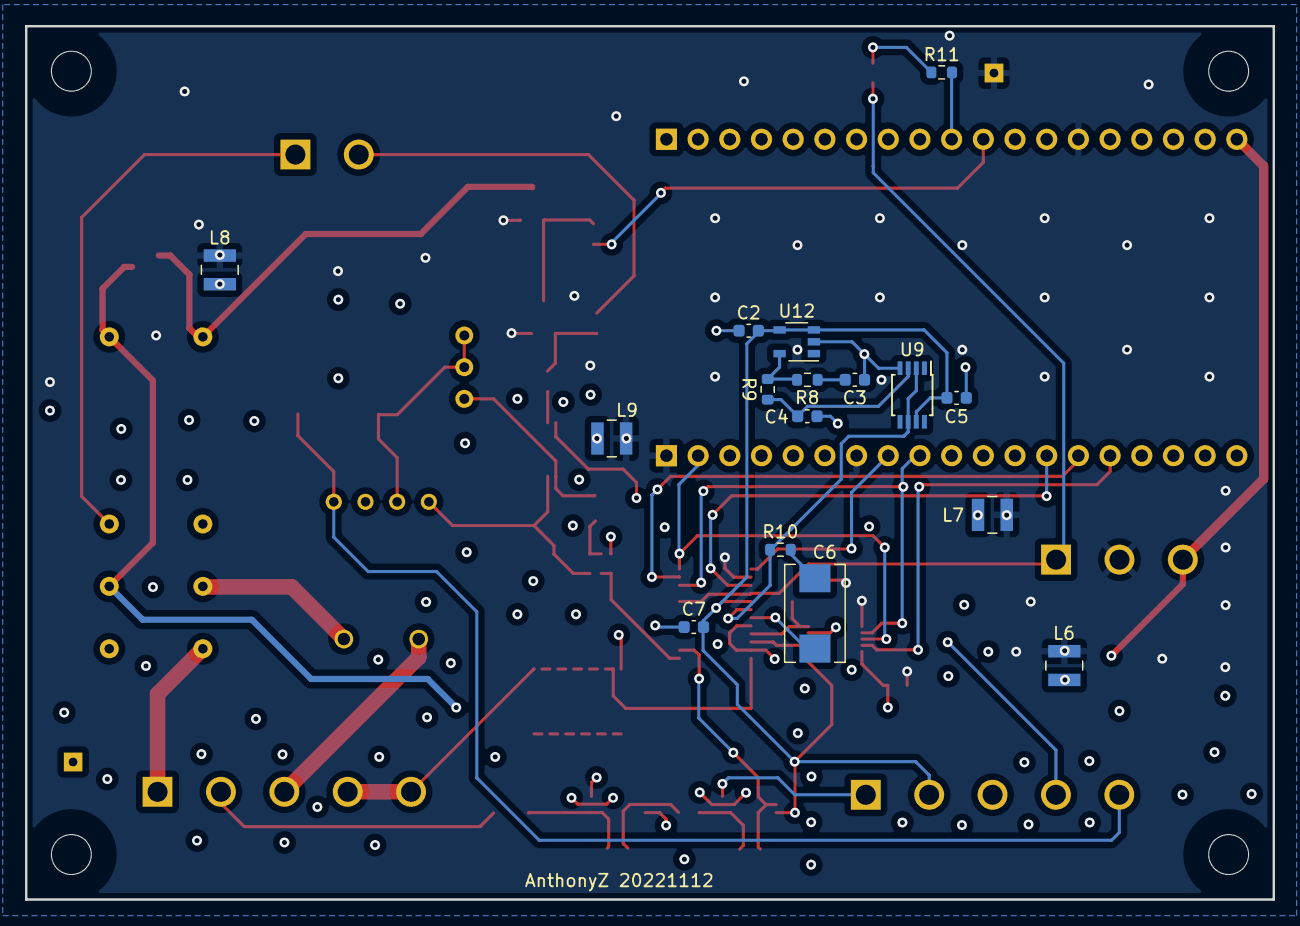
[picture p31: board Sensors.kicad_pcb from below]

Board: 4 copper layers, 100.0 x 70.0 mm, 65 parts (16 on the bottom side), 53 nets.
